twomeylab/c-spam/CSPAM.pdf

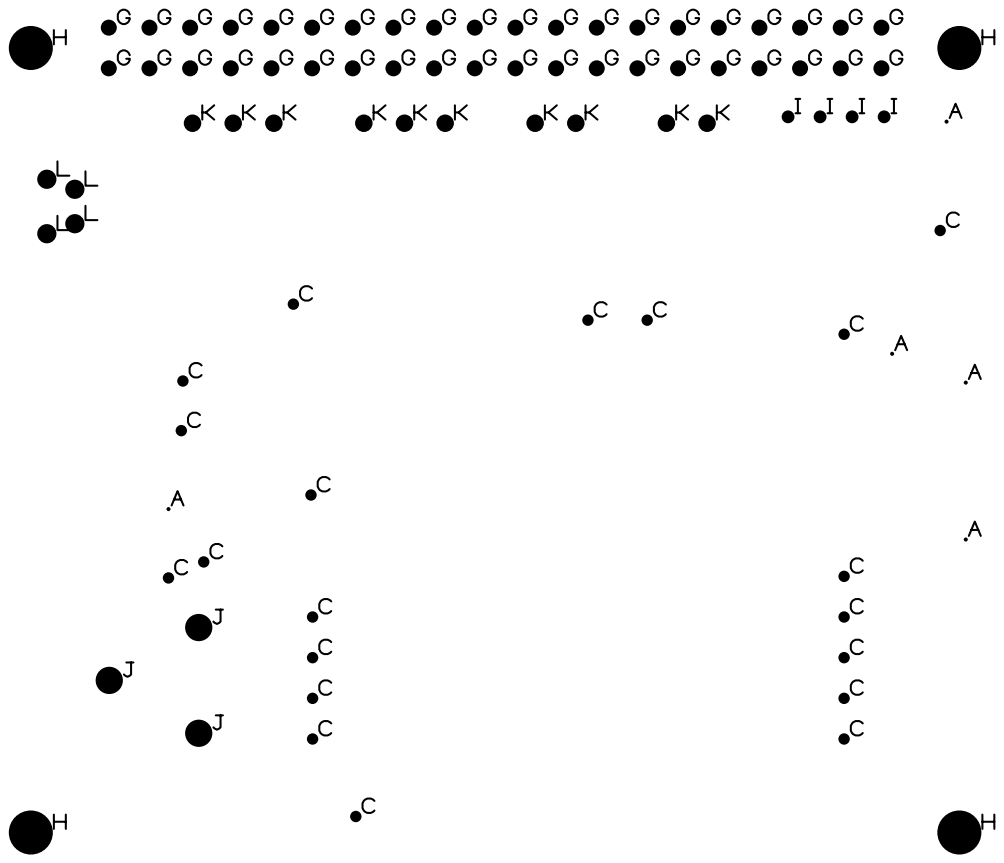
[picture p1: page 1]

M

N

N

M
