twomeylab/c-spam/final_inventory.xlsx

Part Name/Description | Company | Vendor #
3D Parts
Kuhnke_solenoid_magneticstop_with_connection_tab v2.stl | 3D Hubs | 3D Printing/ FDM/ PC Stratasys/ White/ 100µM
Kuhnke_solenoid_holder.stl | 3D Hubs | 3D Printing/ FDM/ PC Stratasys/ White/ 100µM
Magnetic_tweezer_connector_Kunkhe_part.stl | 3D Hubs | 3D Printing/ FDM/ PC Stratasys/ White/ 100µM
ET tweezer mount
ET blotter mount
ET support mount
LED
Mounted LED @ 365nm | ThorLabs | M365L3
Ø1" Adjustable Lens Tube 1.31" Travel Range | ThorLabs | SM1V15
SM1 Lens Tube 1.00" Thread Depth One Retaining Ring Included | ThorLabs | SM1L10
SM1 Lens Tube 0.50" Thread Depth One Retaining Ring Included | ThorLabs | SM1L05
SM1 (1.035"-40) Coupler External Threads 0.25" Long | ThorLabs | SM1T3
SM1 (1.035"-40) Coupler Internal Threads | ThorLabs | SM1T1
Aspheric Condenser Lens Ø1" f=16 mm NA=0.79 ARC: 350-700 nm | ThorLabs | ACL25416U-A
Ø1" Mounted Achromatic Doublets, AR Coated: 400 - 700 nm | ThorLabs | AC254-050-A-ML
N-BK7 Bi-Convex Lens Ø1" f = 60.0 mm ARC: 350-700nm | ThorLabs | LB1596-A
Metric Swivel Post Clamp | ThorLabs | SWC/M
Ø1/2" Optical Post, SS, 8-32 Setscrew, 1/4"-20 Tap, L = 6" | ThorLabs | TR6
SM1 Lens Tube Coupler | ThorLabs | SM1TC
General Build
Plunging solenoid | Summit Electronics | HD8286-R-F - 24VDC
Tapped Linear Motion Shaft, Tapped x Straight End, 52100 Alloy Steel, 1/2" Diameter, 6" Long | McMaster-Carr | 6649K412
1045 Carbon Steel Tapped Rotary Shaft, Tapped End x Straight End, 3/8" Diameter | McMaster-Carr | 6077N112
Round Refrigerator Magnets, 100PCS 6×3MM Small Cylinder Fridge Magnets, Office Magnets, Whiteboard Magnets, Durable Mini Magnets | Amazon
Raspberry Pi 3 Model B+ | DigiKey | 1690-1025-ND
Solenoid Pull 12V | DigiKey | 1528-1551-ND
Cryo tweezers | Nano Soft | 17021002
M6 x 1.0 Stainless Steel Setscrew with Hex on Both Ends 16 mm Long 10 Pack | ThorLabs | SS6M16D
6279-001 Breadboard 24x14 x 1/2 | ThorLabs | MB2424
Armor Coat epoxy putty repair pellets
Cross clamp holders
Whatman filter paper, 25 mm
Universal 24V 6A, AC 100-240V to DC power supply
