twomeylab/c-spam/C-SPAM_tweezer-mount.stl

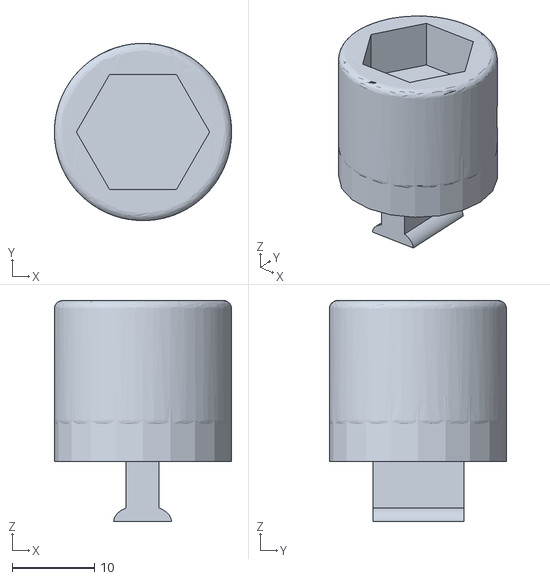
[picture p2: CAD file, 2023-08-16]
C-SPAM_tweezer-mount.stl
21.5 x 21.5 x 26.8
