twomeylab/c-spam/C-SPAM_blot-adapter.stl

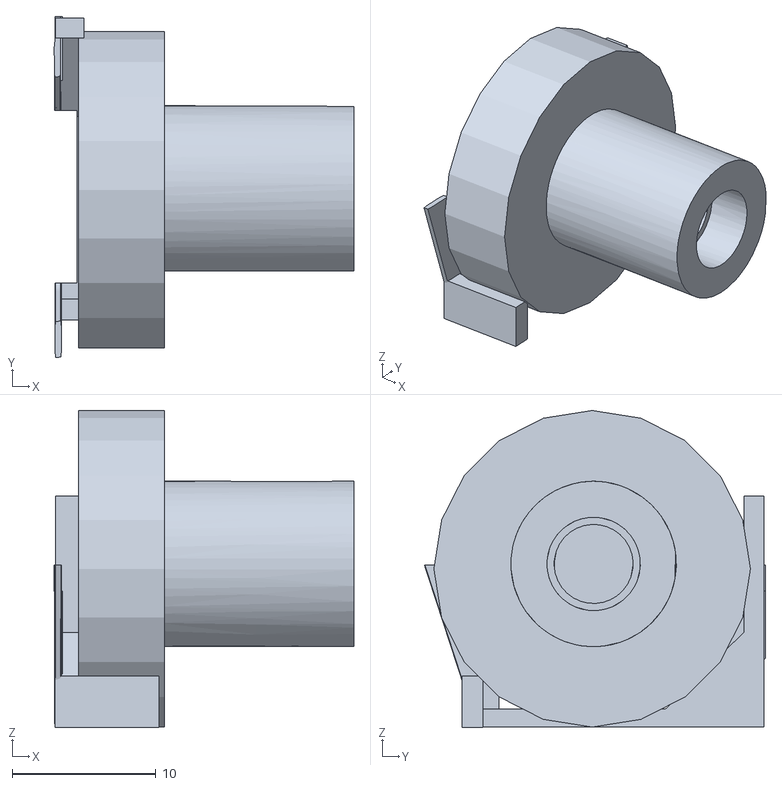
[picture p3: CAD file, 2023-08-16]
C-SPAM_blot-adapter.stl
20.8 x 23.7 x 22.0
