twomeylab/c-spam/C-SPAM_blot-mount.stl

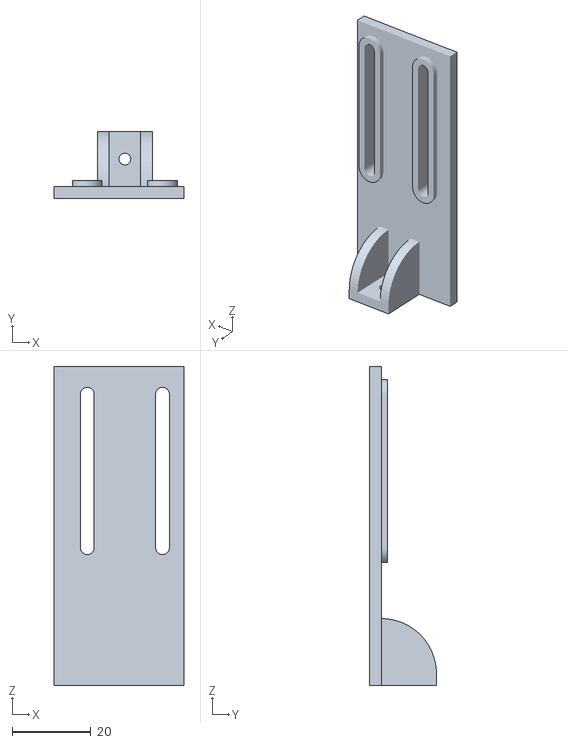
[picture p4: CAD file, 2023-08-16]
C-SPAM_blot-mount.stl
33.0 x 17.0 x 81.0
