twomeylab/c-spam/CSPAMpinlist.py

#!/usr/bin/env python
# coding: utf-8

# In[ ]:


# this file contains a list of RPi GPIO pins used by CSPAM
cannon = 26  # Sprayer
plunger = 13  # Plunge control
filterposition = 19  # Piezo control
sensorpower = 6  # Not used --- always powered up
interlock = 21  #
led = 18  # thorlabs led lamp
pwm0 = 26 # this is is the io pin number of the chip - not the rPi gpio number... Used by LED
