twomeylab/c-spam/(commit log)

2023-08-16 3D Printing Files
    [C-SPAM_blot-adapter.stl, C-SPAM_blot-mount.stl, C-SPAM_tweezer-mount.stl]
2023-08-18 Circuit Board Plan - Hopkins IDG
2023-08-18 Circuit Board Design Files
    [CSPAM(Bottom).gbr, CSPAM(Layer 2).gbr, CSPAM(Layer 3).gbr, CSPAM(Silkscreen Bottom).gbr, CSPAM(Silkscreen Top).gbr, CSPAM(Solder Mask Bottom).gbr, CSPAM(Solder Mask Top).gbr, CSPAM(Through Hole Unplated).drl]
2023-08-18 Parts List
    [final_inventory.xlsx]
